rtreichl/weather_station/eagle/uv-light/Light-UV-Sensor-Board.png

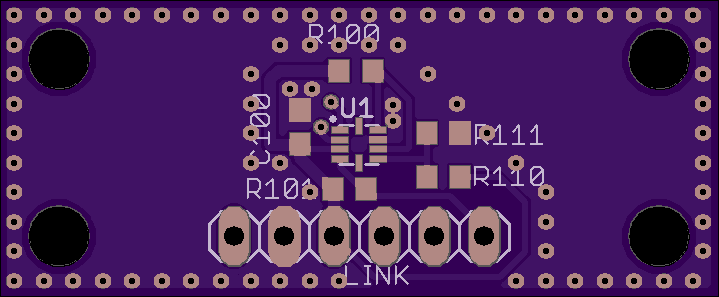
eagle/uv-light/Light-UV-Sensor-Board.png
