rtreichl/weather_station/eagle/uv-light/uv-light-sensor.brd

## EAGLE design eagle/uv-light/uv-light-sensor.brd (2016-05-16)

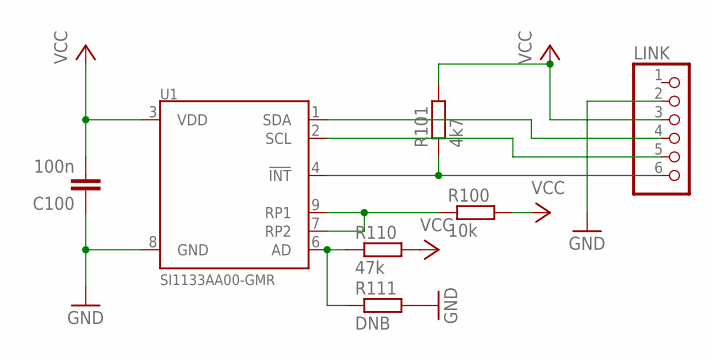
[picture p4: schematic uv-light-sensor.sch]

Parts:
C100: 100n; C0603
LINK: PINHD-1X6; 1X06
R100: 10k; R0603
R101: 4k7; R0603
R110: 47k; R0603
R111: DNB; R0603
U1: SI1133AA00-GMR; QFN-10/2MM

Connections:
GND: C100.1, LINK.2, R111.2, U1.8 (GND)
unnamed: LINK.6, R101.1, U1.4 (!INT)
unnamed: LINK.5, U1.2 (SCL)
unnamed: LINK.4, U1.1 (SDA)
unnamed: R100.1, U1.7 (RP2), U1.9 (RP1)
unnamed: R110.1, R111.1, U1.6 (AD)
VCC: C100.2, LINK.3, R100.2, R101.2, R110.2, U1.3 (VDD)

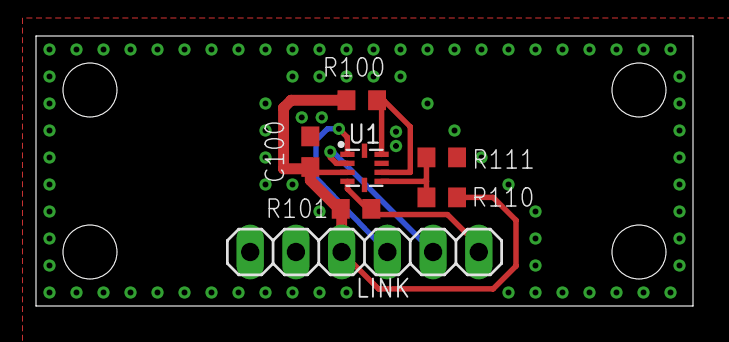
[picture p5: board eagle/uv-light/uv-light-sensor.brd from above]

Board: 2 copper layers, 36.5 x 15.0 mm, 7 parts (0 on the bottom side), 7 nets.
