rtreichl/weather_station/eagle/outdoorsensor/outdoor-sensor.brd

## EAGLE design eagle/outdoorsensor/outdoor-sensor.brd (2016-05-07)

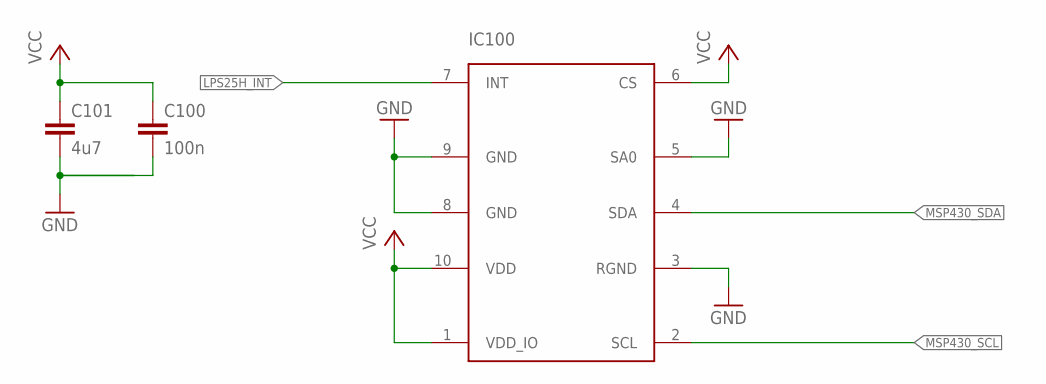
[picture p6: schematic outdoor-sensor.sch, sheet 1, Pressure Sensor LPS25H<br> <a href="http://www.st.com/st-we…]

Parts:
C100: 100n; C0603; MPN STP100NF04
C101: 4u7; C0603
IC100: LPS25H; MPN LPS25HBTR

Connections:
GND: C100.2, C101.2, IC100.3 (RGND), IC100.5 (SA0), IC100.8 (GND), IC100.9 (GND); also elsewhere on the board
LPS25H_INT: IC100.7 (INT); also elsewhere on the board
MSP430_SCL: IC100.2 (SCL); also elsewhere on the board
MSP430_SDA: IC100.4 (SDA); also elsewhere on the board
VCC: C100.1, C101.1, IC100.1 (VDD_IO), IC100.6 (CS), IC100.10 (VDD); also elsewhere on the board

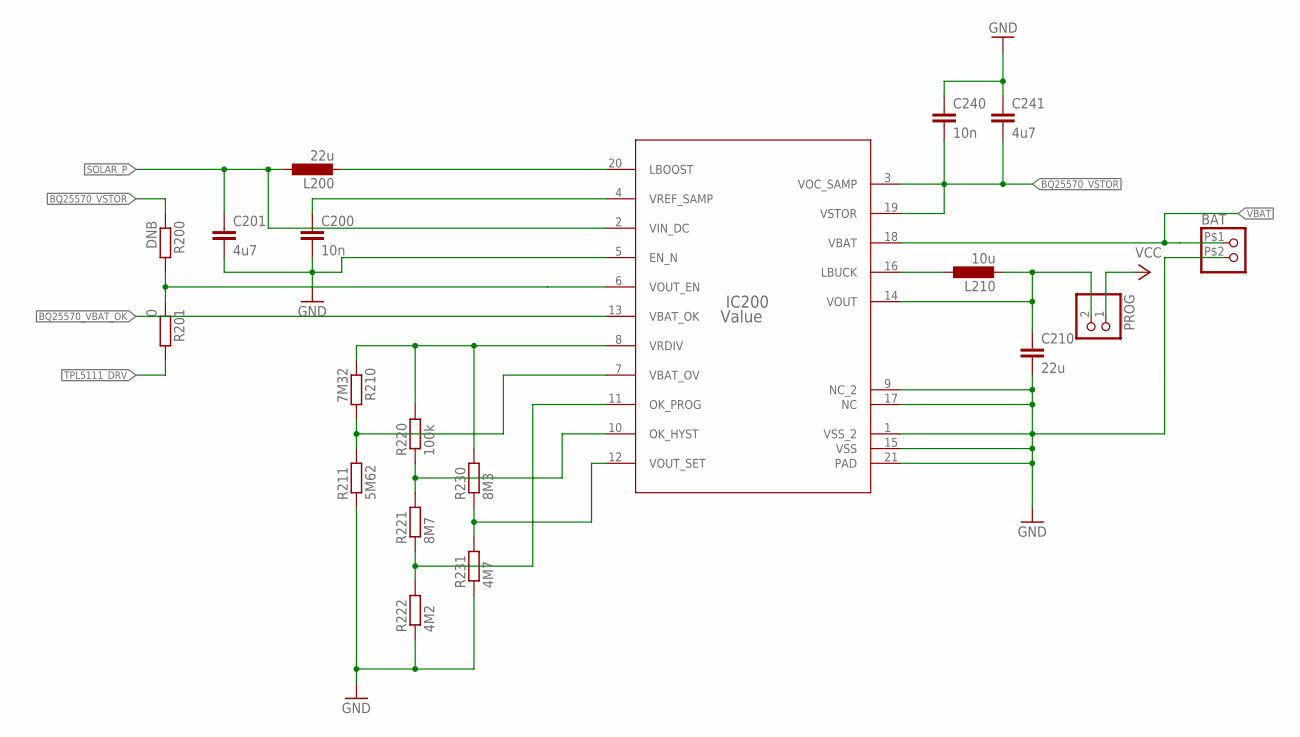
[picture p7: schematic outdoor-sensor.sch, sheet 2, Charger and Buck BQ25570<br> <a href="http://www.ti.com/lit…]

Parts:
!PROG: PINHD-1X2; 1X02
BAT: PINHD-1X2IPBS-102-01-T-S-GP; IPBS-102-01-T-S-GP
C200, C240: 10n; C0603
C201, C241: 4u7; C0603
C210: 22u; C0603; MPN 06034D226MAT2A
IC200: Value; RGR0020A
L200: 22u; L3944
L210: 10u; L2.5X2.0
R200: DNB; R0603
R201: 0; R0603
R210: 7M32; R0603
R211: 5M62; R0603
R220: 100k; R0603
R221: 8M7; R0603
R222: 4M2; R0603
R230: 8M3; R0603
R231: 4M7; R0603

Connections:
BQ25570_VBAT_OK: IC200.13 (VBAT_OK); also elsewhere on the board
BQ25570_VOUT_EN: IC200.6 (VOUT_EN), R200.2, R201.1
BQ25570_VSTOR: C240.2, C241.2, IC200.3 (VOC_SAMP), IC200.19 (VSTOR), R200.1; also elsewhere on the board
GND: BAT.P$2 (2), C200.2, C201.2, C210.2, C240.1, C241.1, IC200.1 (VSS_2), IC200.5 (EN_N), IC200.9 (NC_2), IC200.15 (VSS), IC200.17 (NC), IC200.21 (PAD), R211.1, R222.1, R231.1; also elsewhere on the board
unnamed: IC200.10 (OK_HYST), R220.1, R221.2
unnamed: IC200.8 (VRDIV), R210.1, R220.2, R230.2
unnamed: IC200.7 (VBAT_OV), R210.2, R211.2
unnamed: IC200.11 (OK_PROG), R221.1, R222.2
unnamed: IC200.20 (LBOOST), L200.P$2 (2)
unnamed: C200.1, IC200.4 (VREF_SAMP)
unnamed: IC200.12 (VOUT_SET), R230.1, R231.2
unnamed: !PROG.2, C210.1, IC200.14 (VOUT), L210.P$2 (2)
unnamed: IC200.16 (LBUCK), L210.P$1 (1)
SOLAR_P: C201.1, IC200.2 (VIN_DC), L200.P$1 (1); also elsewhere on the board
TPL5111_DRV: R201.2; also elsewhere on the board
VBAT: BAT.P$1 (1), IC200.18 (VBAT); also elsewhere on the board
VCC: !PROG.1; also elsewhere on the board

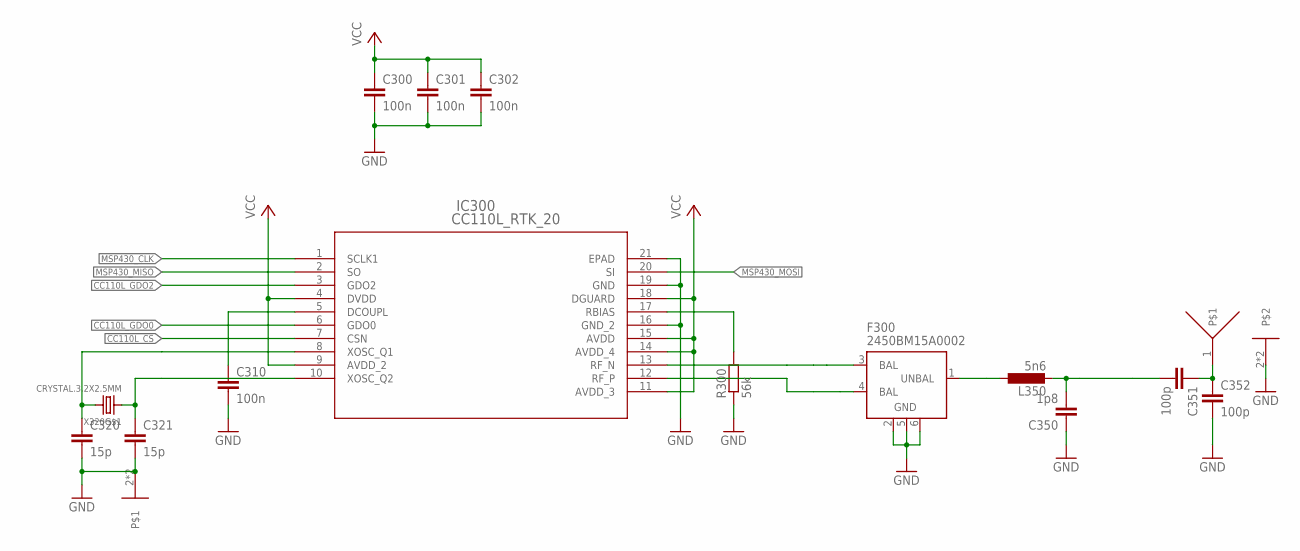
[picture p8: schematic outdoor-sensor.sch, sheet 3, Sub 1-GHz Transceiver CC110L<br> <a href="http://www.ti.com…]

Parts:
C300, C301, C302, C310: 100n; C0603; MPN STP100NF04
C320, C321: 15p; C0603
C350: 1p8; C0603K
C351: 100p; C0603
C352: 100p; C0603K
F300: 2450BM15A0002
IC300: CC110L_RTK_20; RTK20_2P4X2P4
L350: 5n6; L2012C
R300: 56k; R0603
U$1: ANTENNA868W3013-INV; W3013-INV
X320: CRYSTAL.3.2X2.5MM; 3.2X2.5MM

Connections:
!CC110L_CS: IC300.7 (CSN); also elsewhere on the board
CC110L_GDO0: IC300.6 (GDO0); also elsewhere on the board
CC110L_GDO2: IC300.3 (GDO2); also elsewhere on the board
GND: C300.2, C301.2, C302.2, C310.2, C320.2, C321.2, C350.1, C352.2, F300.2 (GND), F300.5 (GND), F300.6 (GND), IC300.16 (GND_2), IC300.19 (GND), IC300.21 (EPAD), R300.1, U$1.2, U$1.3, X320.2, X320.4; also elsewhere on the board
MSP430_CLK: IC300.1 (SCLK1); also elsewhere on the board
MSP430_MISO: IC300.2 (SO); also elsewhere on the board
MSP430_MOSI: IC300.20 (SI); also elsewhere on the board
unnamed: C351.1, C352.1, U$1.1
unnamed: F300.1 (UNBAL), L350.1
unnamed: C320.1, IC300.8 (XOSC_Q1), X320.3 (2)
unnamed: F300.3 (BAL), IC300.13 (RF_N)
unnamed: F300.4 (BAL), IC300.12 (RF_P)
unnamed: C350.2, C351.2, L350.2
unnamed: C310.1, IC300.5 (DCOUPL)
unnamed: IC300.17 (RBIAS), R300.2
unnamed: C321.1, IC300.10 (XOSC_Q2), X320.1
VCC: C300.1, C301.1, C302.1, IC300.4 (DVDD), IC300.9 (AVDD_2), IC300.11 (AVDD_3), IC300.14 (AVDD_4), IC300.15 (AVDD), IC300.18 (DGUARD); also elsewhere on the board

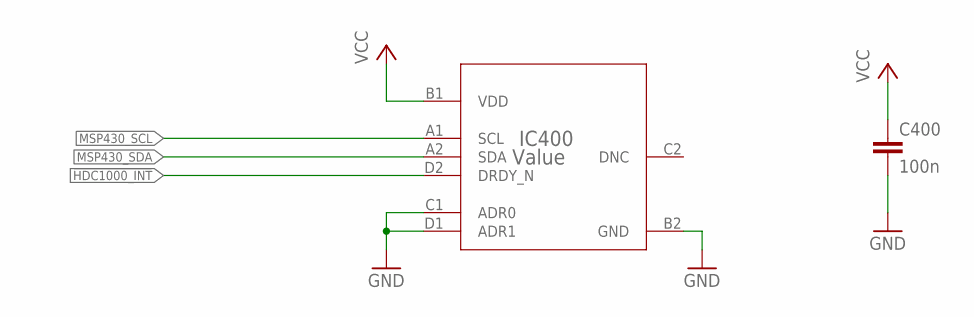
[picture p9: schematic outdoor-sensor.sch, sheet 4, Humidity/Temperature Sensor HDC1000<br> <a href="http://www…]

Parts:
C400: 100n; C0603; MPN STP100NF04
IC400: Value; YPA0008AGAE

Connections:
!HDC1000_INT: IC400.D2 (DRDY_N); also elsewhere on the board
GND: C400.2, IC400.B2 (GND), IC400.C1 (ADR0), IC400.D1 (ADR1); also elsewhere on the board
MSP430_SCL: IC400.A1 (SCL); also elsewhere on the board
MSP430_SDA: IC400.A2 (SDA); also elsewhere on the board
VCC: C400.1, IC400.B1 (VDD); also elsewhere on the board

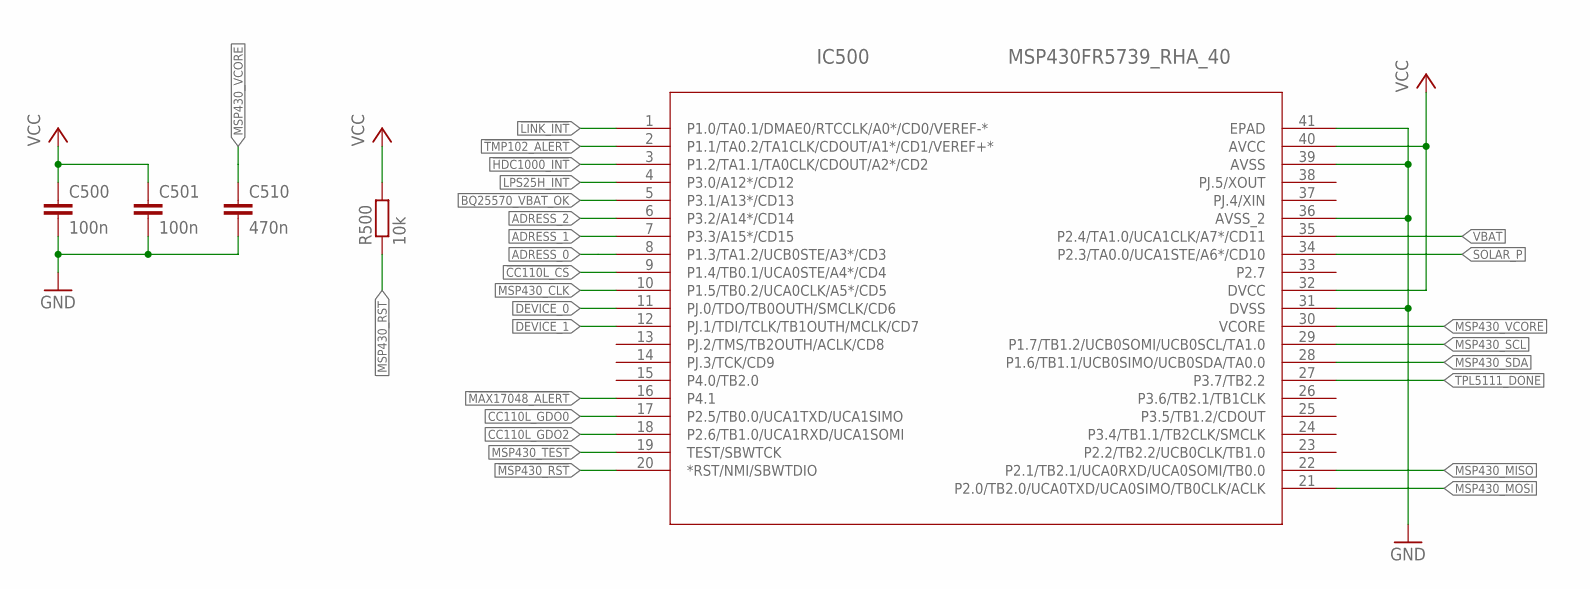
[picture p10: schematic outdoor-sensor.sch, sheet 5, Mikrocontroller]

Parts:
C500, C501: 100n; C0603; MPN STP100NF04
C510: 470n; C0603
IC500: MSP430FR5739_RHA_40; RHA40_2P9X2P9
R500: 10k; R0603

Connections:
!CC110L_CS: IC500.9 (P1.4/TB0.1/UCA0STE/A4*/CD4); also elsewhere on the board
!HDC1000_INT: IC500.3 (P1.2/TA1.1/TA0CLK/CDOUT/A2*/CD2); also elsewhere on the board
!LINK_INT: IC500.1 (P1.0/TA0.1/DMAE0/RTCCLK/A0*/CD0/VEREF-*); also elsewhere on the board
!MAX17048_ALERT: IC500.16 (P4.1); also elsewhere on the board
!MSP430_RST: IC500.20 (*RST/NMI/SBWTDIO), R500.1; also elsewhere on the board
!TMP102_ALERT: IC500.2 (P1.1/TA0.2/TA1CLK/CDOUT/A1*/CD1/VEREF+*); also elsewhere on the board
ADRESS_0: IC500.8 (P1.3/TA1.2/UCB0STE/A3*/CD3); also elsewhere on the board
ADRESS_1: IC500.7 (P3.3/A15*/CD15); also elsewhere on the board
ADRESS_2: IC500.6 (P3.2/A14*/CD14); also elsewhere on the board
BQ25570_VBAT_OK: IC500.5 (P3.1/A13*/CD13); also elsewhere on the board
CC110L_GDO0: IC500.17 (P2.5/TB0.0/UCA1TXD/UCA1SIMO); also elsewhere on the board
CC110L_GDO2: IC500.18 (P2.6/TB1.0/UCA1RXD/UCA1SOMI); also elsewhere on the board
DEVICE_0: IC500.11 (PJ.0/TDO/TB0OUTH/SMCLK/CD6); also elsewhere on the board
DEVICE_1: IC500.12 (PJ.1/TDI/TCLK/TB1OUTH/MCLK/CD7); also elsewhere on the board
GND: C500.2, C501.2, C510.2, IC500.31 (DVSS), IC500.36 (AVSS_2), IC500.39 (AVSS), IC500.41 (EPAD); also elsewhere on the board
LPS25H_INT: IC500.4 (P3.0/A12*/CD12); also elsewhere on the board
MSP430_CLK: IC500.10 (P1.5/TB0.2/UCA0CLK/A5*/CD5); also elsewhere on the board
MSP430_MISO: IC500.22 (P2.1/TB2.1/UCA0RXD/UCA0SOMI/TB0.0); also elsewhere on the board
MSP430_MOSI: IC500.21 (P2.0/TB2.0/UCA0TXD/UCA0SIMO/TB0CLK/ACLK); also elsewhere on the board
MSP430_SCL: IC500.29 (P1.7/TB1.2/UCB0SOMI/UCB0SCL/TA1.0); also elsewhere on the board
MSP430_SDA: IC500.28 (P1.6/TB1.1/UCB0SIMO/UCB0SDA/TA0.0); also elsewhere on the board
MSP430_TEST: IC500.19 (TEST/SBWTCK); also elsewhere on the board
MSP430_VCORE: C510.1, IC500.30 (VCORE)
SOLAR_P: IC500.34 (P2.3/TA0.0/UCA1STE/A6*/CD10); also elsewhere on the board
TPL5111_DONE: IC500.27 (P3.7/TB2.2); also elsewhere on the board
VBAT: IC500.35 (P2.4/TA1.0/UCA1CLK/A7*/CD11); also elsewhere on the board
VCC: C500.1, C501.1, IC500.32 (DVCC), IC500.40 (AVCC), R500.2; also elsewhere on the board

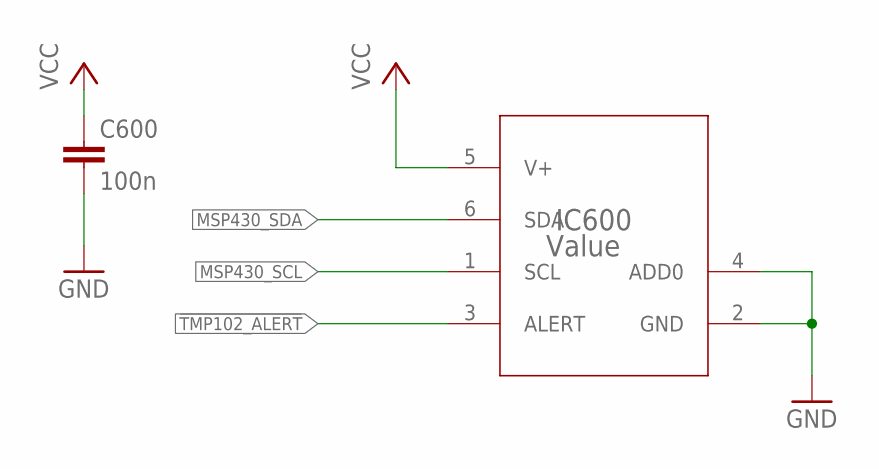
[picture p11: schematic outdoor-sensor.sch, sheet 6, Temperature Sensor TMP102-Q1<br> <a href="http://www.ti.com…]

Parts:
C600: 100n; C0603; MPN STP100NF04
IC600: Value; DRL0006A

Connections:
!TMP102_ALERT: IC600.3 (ALERT); also elsewhere on the board
GND: C600.2, IC600.2 (GND), IC600.4 (ADD0); also elsewhere on the board
MSP430_SCL: IC600.1 (SCL); also elsewhere on the board
MSP430_SDA: IC600.6 (SDA); also elsewhere on the board
VCC: C600.1, IC600.5 (V+); also elsewhere on the board

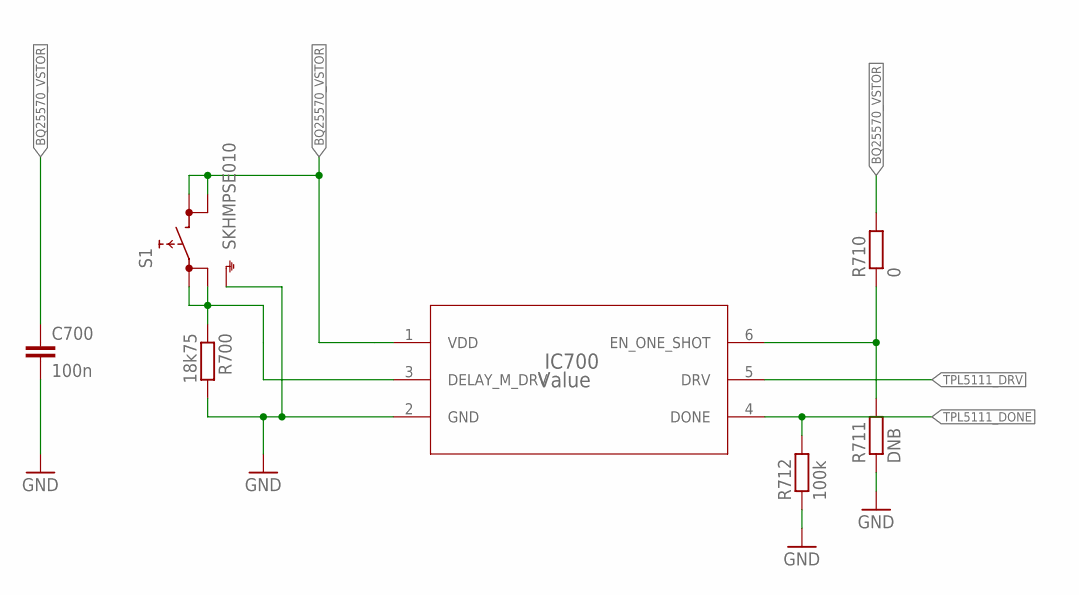
[picture p12: schematic outdoor-sensor.sch, sheet 7, Nano low power timer TPL5010<br> <a href="http://www.ti.com…]

Parts:
C700: 100n; C0603; MPN STP100NF04
IC700: Value; DDC0006A_N
R700: 18k75; R0603
R710: 0; R0603
R711: DNB; R0603
R712: 100k; R0603
S1: SKHMPSE010; SKHMPXE010

Connections:
BQ25570_VSTOR: C700.1, IC700.1 (VDD), R710.2, S1.3 (2.1), S1.4 (2.2); also elsewhere on the board
GND: C700.2, IC700.2 (GND), R700.2, R711.1, R712.1, S1.5 (SH); also elsewhere on the board
unnamed: IC700.3 (DELAY_M_DRV), R700.1, S1.1 (1.1), S1.2 (1.2)
TPL5010_RST_N: IC700.6 (EN_ONE_SHOT), R710.1, R711.2
TPL5111_DONE: IC700.4 (DONE), R712.2; also elsewhere on the board
TPL5111_DRV: IC700.5 (DRV); also elsewhere on the board

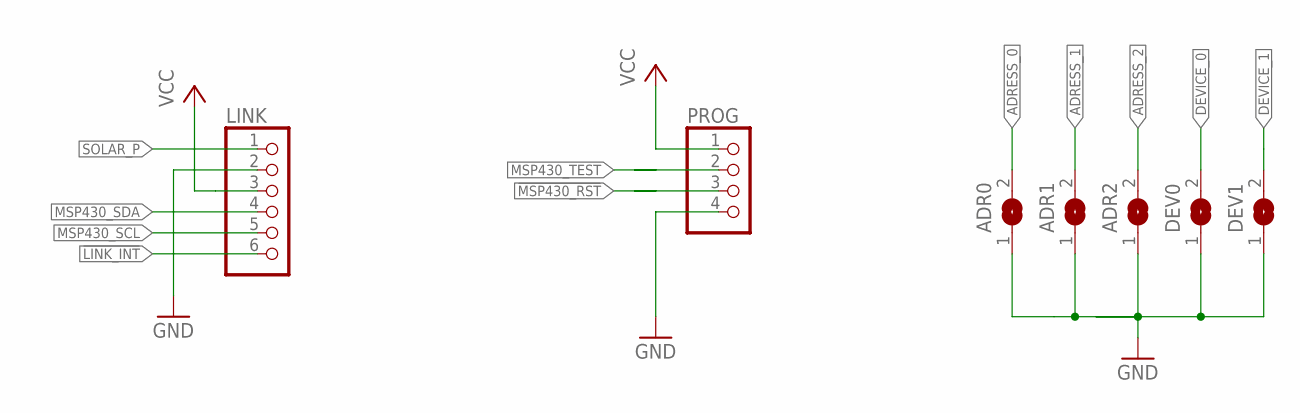
[picture p13: schematic outdoor-sensor.sch, sheet 8, Connectors]

Parts:
ADR0, ADR1, ADR2: SJW
DEV0, DEV1: SJW
LINK: PINHD-1X6; 1X06
PROG: PINHD-1X4; 1X04

Connections:
!LINK_INT: LINK.6; also elsewhere on the board
!MSP430_RST: PROG.3; also elsewhere on the board
ADRESS_0: ADR0.2; also elsewhere on the board
ADRESS_1: ADR1.2; also elsewhere on the board
ADRESS_2: ADR2.2; also elsewhere on the board
DEVICE_0: DEV0.2; also elsewhere on the board
DEVICE_1: DEV1.2; also elsewhere on the board
GND: ADR0.1, ADR1.1, ADR2.1, DEV0.1, DEV1.1, LINK.2, PROG.4; also elsewhere on the board
MSP430_SCL: LINK.5; also elsewhere on the board
MSP430_SDA: LINK.4; also elsewhere on the board
MSP430_TEST: PROG.2; also elsewhere on the board
SOLAR_P: LINK.1; also elsewhere on the board
VCC: LINK.3, PROG.1; also elsewhere on the board

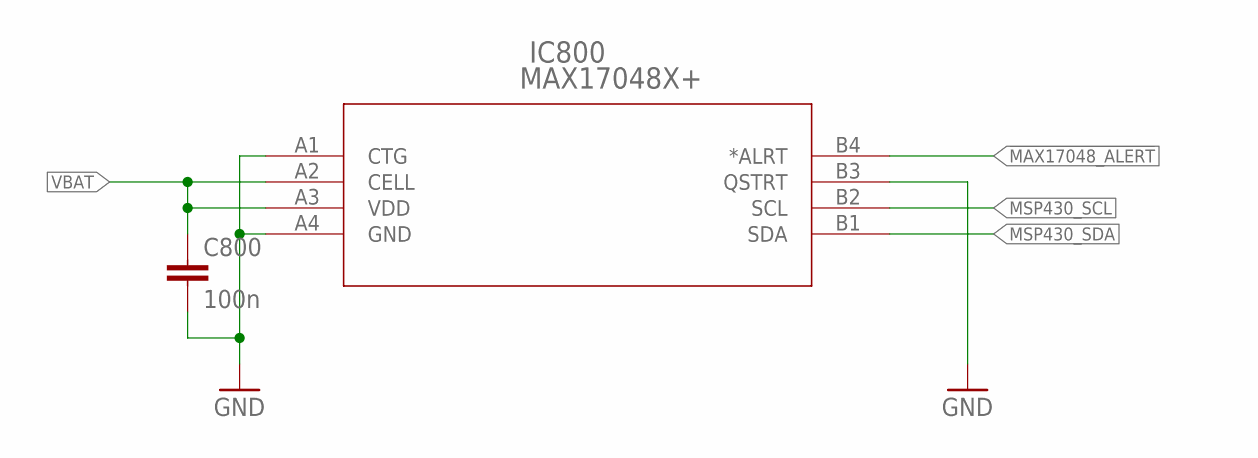
[picture p14: schematic outdoor-sensor.sch, sheet 9]

Parts:
C800: 100n; C0603
IC800: MAX17048X+; 21-0555B_W80B1-1

Connections:
!MAX17048_ALERT: IC800.B4 (*ALRT); also elsewhere on the board
GND: C800.2, IC800.A1 (CTG), IC800.A4 (GND), IC800.B3 (QSTRT); also elsewhere on the board
MSP430_SCL: IC800.B2 (SCL); also elsewhere on the board
MSP430_SDA: IC800.B1 (SDA); also elsewhere on the board
VBAT: C800.1, IC800.A2 (CELL), IC800.A3 (VDD); also elsewhere on the board

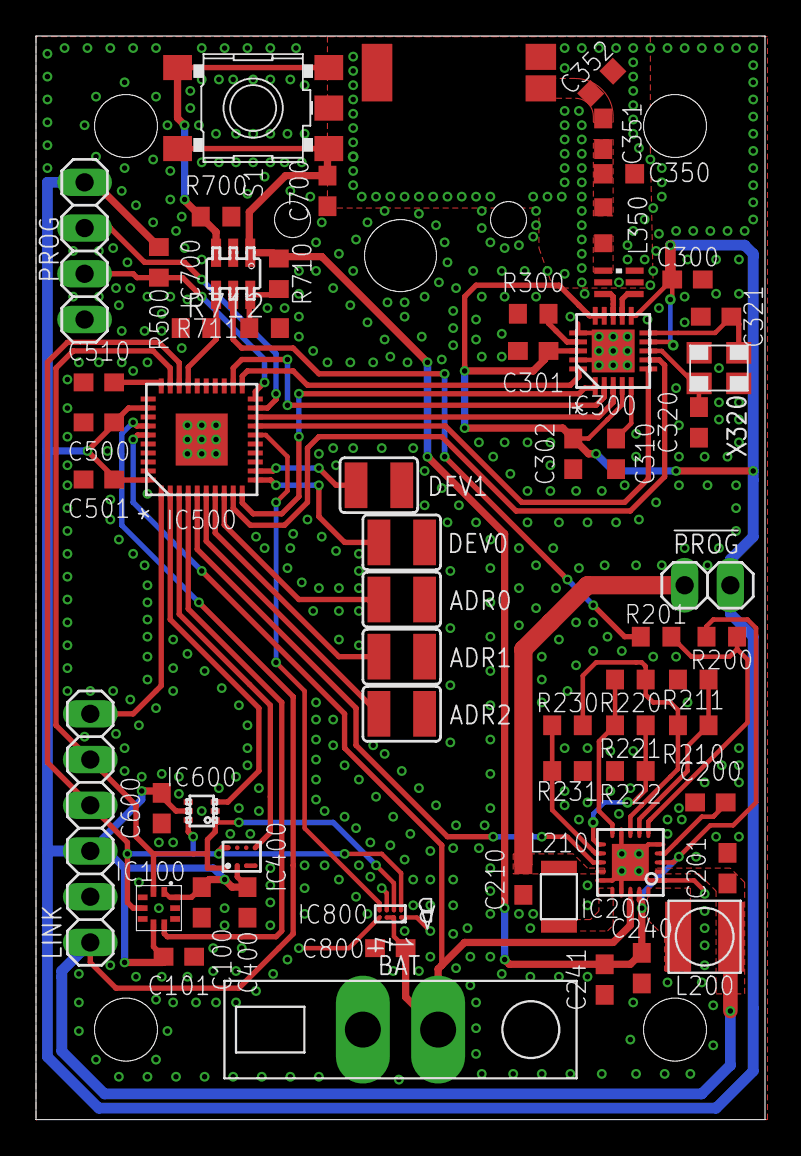
[picture p15: board outdoor-sensor.brd from above]

Board: 2 copper layers, 40.5 x 60.2 mm, 62 parts (0 on the bottom side), 50 nets.
