rtreichl/weather_station/eagle/rapi-receiver/receiver.brd

## EAGLE design eagle/rapi-receiver/receiver.brd (2015-10-21)

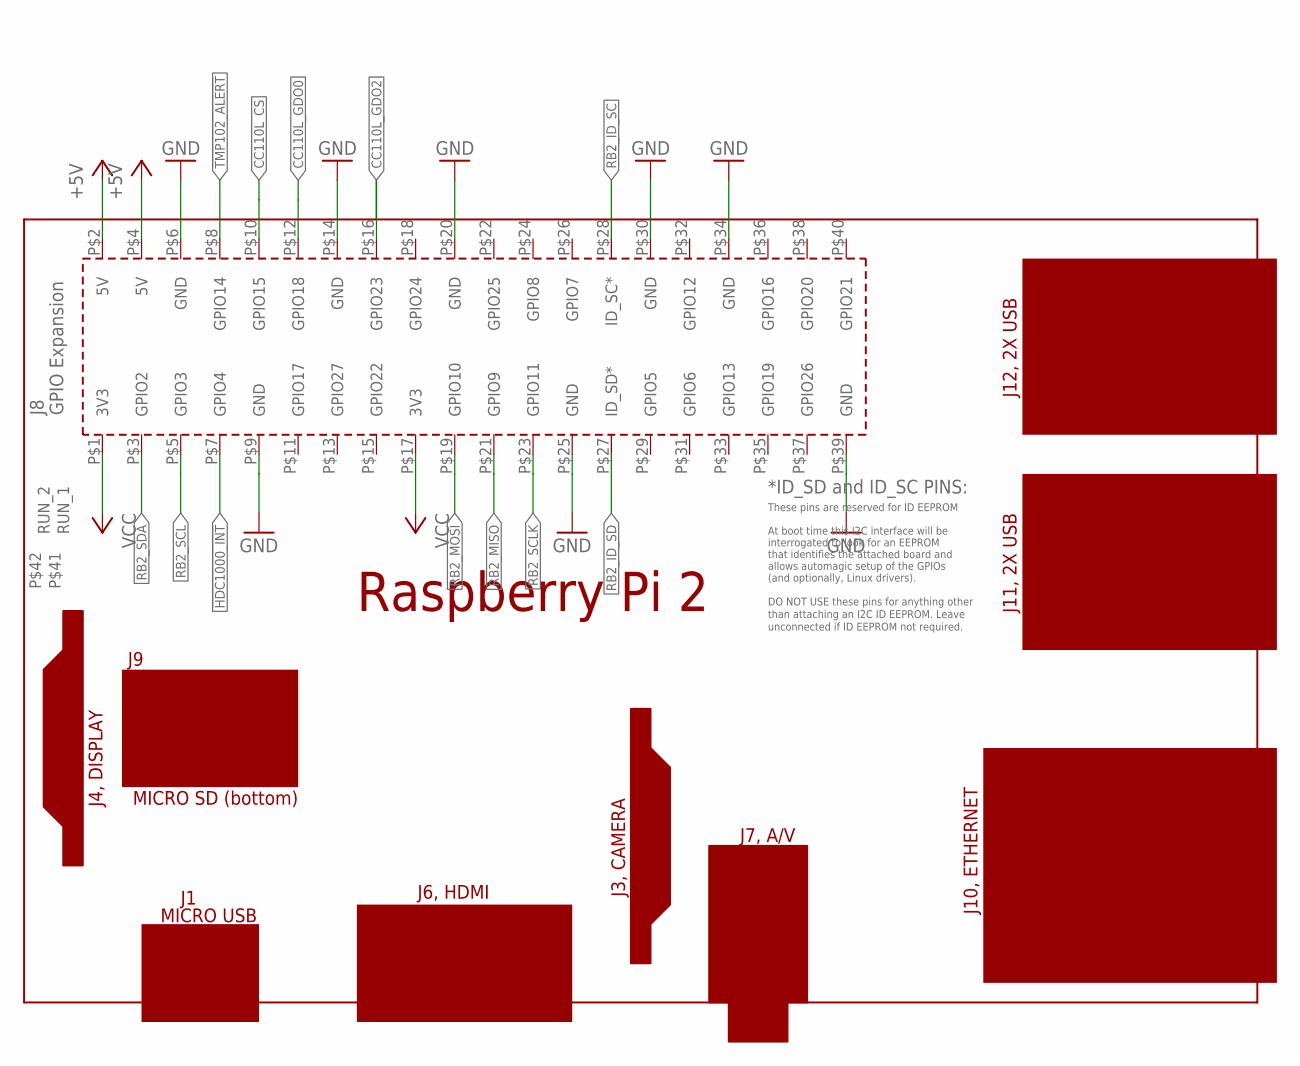
[picture p16: schematic receiver.sch, sheet 1, Raspberry PI 2 Extention Board<br> <a href="http://elinux.o…]

Parts:
PCB1: RPI2

Connections:
!HDC1000_INT: PCB1.P$7 (GPIO4); also elsewhere on the board
!TMP102_ALERT: PCB1.P$8 (GPIO14); also elsewhere on the board
+5V: PCB1.P$2 (5V), PCB1.P$4 (5V)
CC110L_CS: PCB1.P$10 (GPIO15); also elsewhere on the board
CC110L_GDO0: PCB1.P$12 (GPIO18); also elsewhere on the board
CC110L_GDO2: PCB1.P$16 (GPIO23); also elsewhere on the board
GND: PCB1.P$6 (GND), PCB1.P$9 (GND), PCB1.P$14 (GND), PCB1.P$20 (GND), PCB1.P$25 (GND), PCB1.P$30 (GND), PCB1.P$34 (GND), PCB1.P$39 (GND); also elsewhere on the board
RB2_ID_SC: PCB1.P$28 (ID_SC*); also elsewhere on the board
RB2_ID_SD: PCB1.P$27 (ID_SD*); also elsewhere on the board
RB2_MISO: PCB1.P$21 (GPIO9); also elsewhere on the board
RB2_MOSI: PCB1.P$19 (GPIO10); also elsewhere on the board
RB2_SCL: PCB1.P$5 (GPIO3); also elsewhere on the board
RB2_SCLK: PCB1.P$23 (GPIO11); also elsewhere on the board
RB2_SDA: PCB1.P$3 (GPIO2); also elsewhere on the board
VCC: PCB1.P$1 (3V3), PCB1.P$17 (3V3); also elsewhere on the board

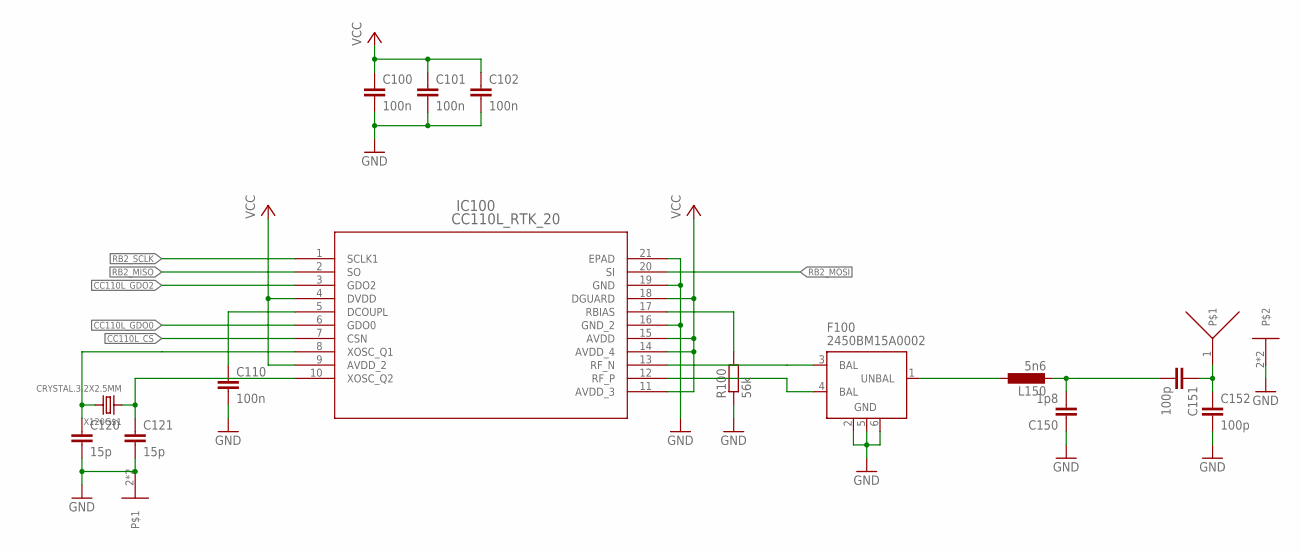
[picture p17: schematic receiver.sch, sheet 2, Transceiver CC110L<br> <a href="http://www.ti.com/lit/ds/sy…]

Parts:
C100, C101, C102, C110: 100n; C0603
C120, C121: 15p; C0603
C150: 1p8; C0603K
C151: 100p; C0603
C152: 100p; C0603K
F100: 2450BM15A0002
IC100: CC110L_RTK_20; RTK20_2P4X2P4
L150: 5n6; L2012C
R100: 56k; R0603
U$1: ANTENNA868W3013-INV; W3013-INV
X120: CRYSTAL.3.2X2.5MM; 3.2X2.5MM

Connections:
CC110L_CS: IC100.7 (CSN); also elsewhere on the board
CC110L_GDO0: IC100.6 (GDO0); also elsewhere on the board
CC110L_GDO2: IC100.3 (GDO2); also elsewhere on the board
GND: C100.2, C101.2, C102.2, C110.2, C120.2, C121.2, C150.1, C152.2, F100.2 (GND), F100.5 (GND), F100.6 (GND), IC100.16 (GND_2), IC100.19 (GND), IC100.21 (EPAD), R100.1, U$1.2, U$1.3, X120.2, X120.4; also elsewhere on the board
unnamed: C151.1, C152.1, U$1.1
unnamed: C120.1, IC100.8 (XOSC_Q1), X120.3 (2)
unnamed: F100.1 (UNBAL), L150.1
unnamed: F100.3 (BAL), IC100.13 (RF_N)
unnamed: F100.4 (BAL), IC100.12 (RF_P)
unnamed: C150.2, C151.2, L150.2
unnamed: C110.1, IC100.5 (DCOUPL)
unnamed: IC100.17 (RBIAS), R100.2
unnamed: C121.1, IC100.10 (XOSC_Q2), X120.1
RB2_MISO: IC100.2 (SO); also elsewhere on the board
RB2_MOSI: IC100.20 (SI); also elsewhere on the board
RB2_SCLK: IC100.1 (SCLK1); also elsewhere on the board
VCC: C100.1, C101.1, C102.1, IC100.4 (DVDD), IC100.9 (AVDD_2), IC100.11 (AVDD_3), IC100.14 (AVDD_4), IC100.15 (AVDD), IC100.18 (DGUARD); also elsewhere on the board

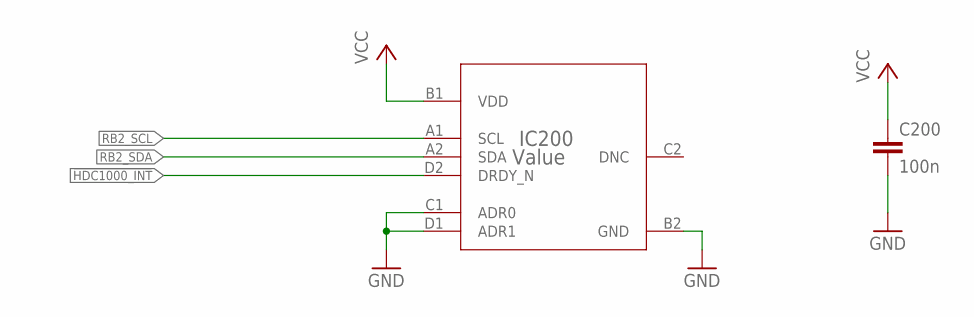
[picture p18: schematic receiver.sch, sheet 3, Humidity and Temperature Sensor HDC1000<br> <a href="http:/…]

Parts:
C200: 100n; C0603
IC200: Value; YPA0008AGAE

Connections:
!HDC1000_INT: IC200.D2 (DRDY_N); also elsewhere on the board
GND: C200.2, IC200.B2 (GND), IC200.C1 (ADR0), IC200.D1 (ADR1); also elsewhere on the board
RB2_SCL: IC200.A1 (SCL); also elsewhere on the board
RB2_SDA: IC200.A2 (SDA); also elsewhere on the board
VCC: C200.1, IC200.B1 (VDD); also elsewhere on the board

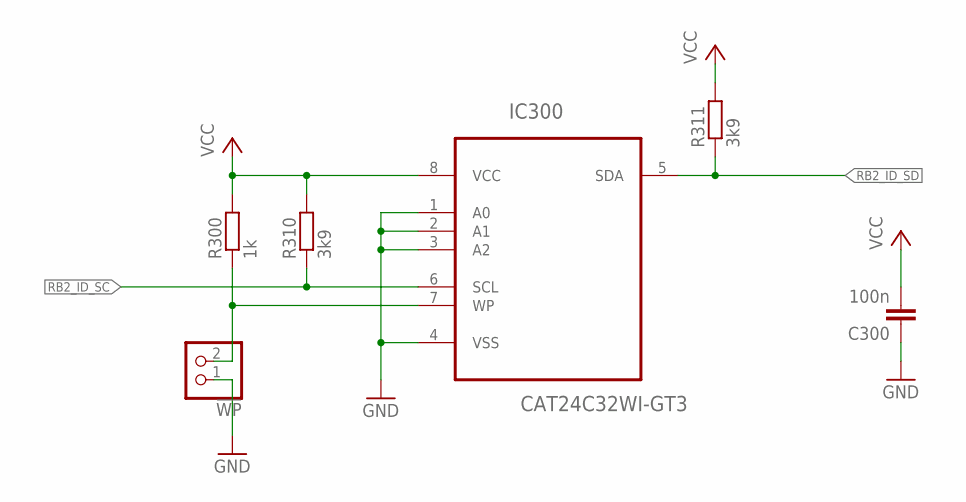
[picture p19: schematic receiver.sch, sheet 4, EEPROM CAT24C32WI<br> <a href="http://www.onsemi.com/pub_li…]

Parts:
!WP: PINHD-1X2; 1X02
C300: 100n; C0603
IC300: CAT24C32WI-GT3; SOIC127P600X175-8N
R300: 1k; R0603
R310, R311: 3k9; R0603

Connections:
GND: !WP.1, C300.1, IC300.1 (A0), IC300.2 (A1), IC300.3 (A2), IC300.4 (VSS); also elsewhere on the board
unnamed: !WP.2, IC300.7 (WP), R300.1
RB2_ID_SC: IC300.6 (SCL), R310.1; also elsewhere on the board
RB2_ID_SD: IC300.5 (SDA), R311.1; also elsewhere on the board
VCC: C300.2, IC300.8 (VCC), R300.2, R310.2, R311.2; also elsewhere on the board

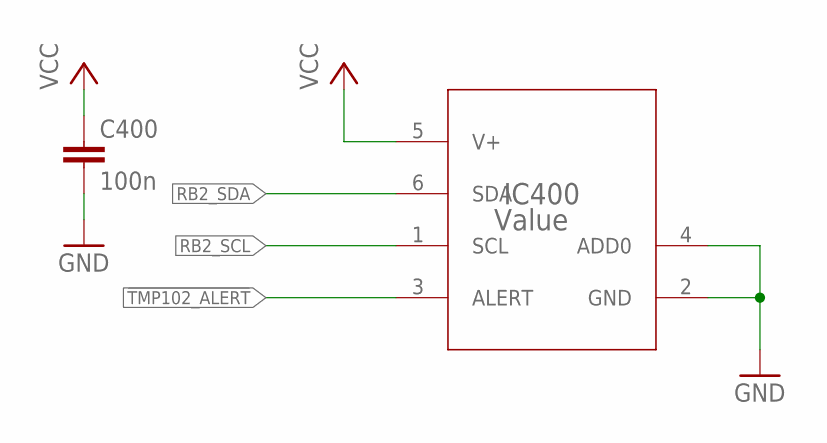
[picture p20: schematic receiver.sch, sheet 5, Temperature Sensor<br> <a href="http://www.ti.com/lit/ds/sy…]

Parts:
C400: 100n; C0603
IC400: Value; DRL0006A

Connections:
!TMP102_ALERT: IC400.3 (ALERT); also elsewhere on the board
GND: C400.2, IC400.2 (GND), IC400.4 (ADD0); also elsewhere on the board
RB2_SCL: IC400.1 (SCL); also elsewhere on the board
RB2_SDA: IC400.6 (SDA); also elsewhere on the board
VCC: C400.1, IC400.5 (V+); also elsewhere on the board

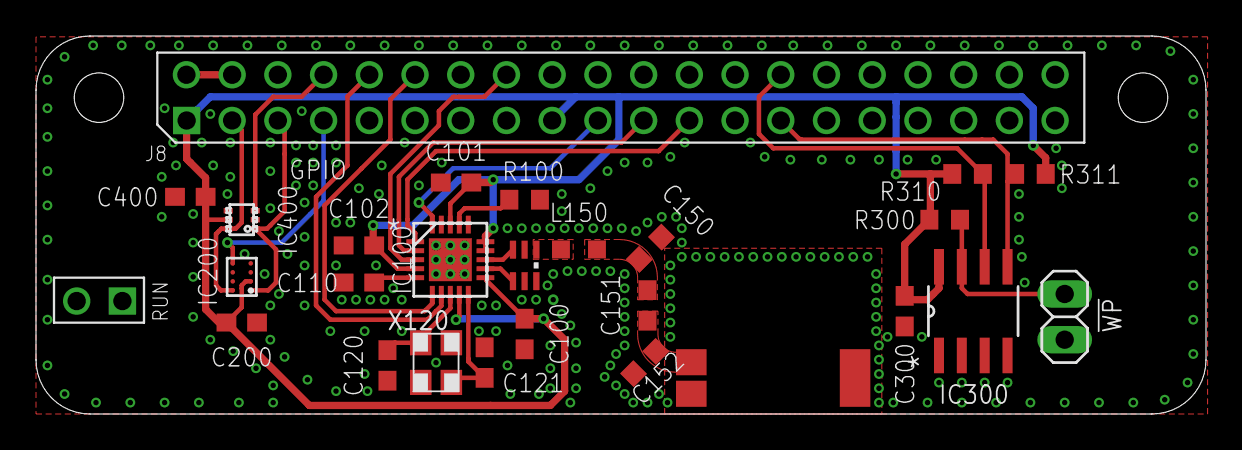
[picture p21: board receiver.brd from above]

Board: 2 copper layers, 65.0 x 21.0 mm, 26 parts (0 on the bottom side), 25 nets.
