rtreichl/weather_station/eagle/light/uv-light-sensor.brd

## EAGLE design eagle/light/uv-light-sensor.brd (2015-08-13)

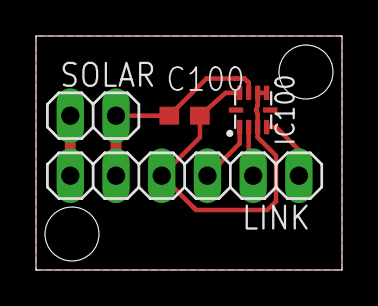
[picture p22: board eagle/light/uv-light-sensor.brd from above]

Board: 2 copper layers, 17.0 x 13.0 mm, 4 parts (0 on the bottom side), 6 nets.

Parts:
C100: 100n; C0603
IC100: SI1147; QFN-10/2MM
LINK: 1X06
SOLAR: 1X02

Connections:
GND: C100.1, IC100.8, LINK.2, SOLAR.1
unnamed: IC100.4, LINK.6
unnamed: IC100.2, LINK.5
unnamed: IC100.1, LINK.4
unnamed: LINK.1, SOLAR.2
VCC: C100.2, IC100.3, IC100.6, IC100.7, IC100.9, LINK.3
