rtreichl/weather_station/msp430/OutdoorSensor/driver/intern/gpio/src/gpio.c

///----------------------------------------------------------------------------------------
///
/// \file gpio.c
///
/// \brief 
///
/// \date 17.02.2016
///
/// \author Richard Treichl
///
/// \remark
///
/// \todo
///
/// \version	1.0
///
///----------------------------------------------------------------------------------------

#include <driver.h>
#include "../include/gpio.h"

#ifdef __MSP430_HAS_PORT1_R__
#if GPIO_PORT1_INTERRUPT == GPIO_INTERRUPT_ON
	extern gpio_ptrfunc gpio1_isrs[];
#endif
#endif
#ifdef __MSP430_HAS_PORT2_R__
#if GPIO_PORT2_INTERRUPT == GPIO_INTERRUPT_ON
	extern gpio_ptrfunc gpio2_isrs[];
#endif
#endif
#ifdef __MSP430_HAS_PORT3_R__
#if GPIO_PORT3_INTERRUPT == GPIO_INTERRUPT_ON
	extern gpio_ptrfunc gpio3_isrs[];
#endif
#endif
#ifdef __MSP430_HAS_PORT4_R__
#if GPIO_PORT4_INTERRUPT == GPIO_INTERRUPT_ON
	extern gpio_ptrfunc gpio4_isrs[];
#endif
#endif
#ifdef __MSP430_HAS_PORT5_R__
#if GPIO_PORT5_INTERRUPT == GPIO_INTERRUPT_ON
	extern gpio_ptrfunc gpio5_isrs[];
#endif
#endif
#ifdef __MSP430_HAS_PORT6_R__
#if GPIO_PORT6_INTERRUPT == GPIO_INTERRUPT_ON
	extern gpio_ptrfunc gpio6_isrs[];
#endif
#endif
#ifdef __MSP430_HAS_PORT7_R__
#if GPIO_PORT7_INTERRUPT == GPIO_INTERRUPT_ON
	extern gpio_ptrfunc gpio7_isrs[];
#endif
#endif
#ifdef __MSP430_HAS_PORT8_R__
#if GPIO_PORT8_INTERRUPT == GPIO_INTERRUPT_ON
	extern gpio_ptrfunc gpio8_isrs[];
#endif
#endif
#ifdef __MSP430_HAS_PORT9_R__
#if GPIO_PORT9_INTERRUPT == GPIO_INTERRUPT_ON
	extern gpio_ptrfunc gpio9_isrs[];
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
		break;
#endif
#endif
	default:
		break;
	}
	return 0;
}

uint16_t GpioEnableInterupt(GPIO8_PORT port, GPIO_PIN pin)
{
	GPIO8_IFG(port) &= ~pin;
	GPIO8_IE(port) |= pin;
	return 0;
}

uint16_t GpioDisableInterupt(GPIO8_PORT port, GPIO_PIN pin)
{
	GPIO8_IE(port) &= ~pin;
	return 0;
}
