rtreichl/weather_station/msp430/OutdoorSensor/app/src/communication.c

///----------------------------------------------------------------------------------------
///
/// \file communication.c
///
/// \brief 
///
/// \date 26.02.2016
///
/// \author Richard Treichl
///
/// \remark
///
/// \todo
///
/// \version	1.0
///
///----------------------------------------------------------------------------------------

//uint16_t communication_init()
//{
//	return 0;
//}
//
//uint16_t communication_registration()
//{
//	//Header -> Protocol for registaiton
//	//Wait for -> Response and next time Slot
//	return 0;
//}
//
//uint16_t communication_send_information()
//{
//	//Header -> Protocol for information msb(2) for information lsb(6)
//	PROTOCOL_STC Protocol;
//	Protocol.dest_addr = 0;
//
//	//Wait for -> Response and offset time
//	return 0;
//}
//
//uint16_t communication_send_data()
//{
//	//Header -> Protocol for data msb(2) for data lsb(6)
//	//Go offline
//	return 0;
//}
