rtreichl/weather_station/raspi/receiver/src/configfile.h

/*
 * CONFIGFILE.h
 *
 *  Created on: 04.02.2016
 *      Author: Richard Treichl
 */

#ifndef CONFIGFILE_H_
#define CONFIGFILE_H_

class CONFIGFILE {
public:
	CONFIGFILE();
	virtual ~CONFIGFILE();
};

#endif /* CONFIGFILE_H_ */
