rtreichl/weather_station/(commit log)

2015-08-13 ADD: Schematics and layout for outdoor light sensor and receiver for raspberry pi 2
    [outdoor-sensor.brd, outdoor-sensor.sch, receiver.brd, receiver.sch, uv-light-sensor.brd, uv-light-sensor.sch]
2015-10-21 CHG: updated lib, schematics and boards
    [outdoor-sensor.brd, outdoor-sensor.sch, receiver.brd, receiver.sch, uv-light-sensor.brd, uv-light-sensor.sch]
2016-01-28 CHG: Updated schematics and layout
    [outdoor-sensor.brd, outdoor-sensor.sch]
2016-02-17 CHG: Removed extern_interrupt_handler and replaced with with new gpio interface
    [gpio.c, gpio.h, gpio_port1.c, gpio_port10.c, gpio_port11.c, gpio_port2.c, gpio_port3.c, gpio_port4.c]
2016-02-17 CHG: Added new timer interface
2016-02-17 CHG: reworked database data handling and added rssi for database insert
    [database.cpp, database.h]
2016-02-17 FIX: fixed some bugs on cc110l driver
    [cc110l.cpp, cc110l.h, cc110l_config2.h]
2016-02-26 FIX: Moved config from ram to rom
    [cc110l_config2.h]
2016-02-26 ADD: added a onewire driver. Port and Pin are selectable
2016-02-26 CHG: Improved timer driver and fixed some bugs
2016-02-26 ADD: Added an check slave function to i2c for checking availability
2016-02-26 ADD: Added driver for DS18B20 Temp. sensor
2016-02-26 FIX: fixed a bug with GPIO ISR
    [gpio_port1.c]
2016-02-26 ADD: Added files for driver lib. Driver lib will be moved out of this repo. to a independently one
2016-02-29 ADD: added a i2c_slave_check function to prove if the slave exists
2016-02-29 CHG: SPI clock divider is now 2 instead of 4
2016-05-07 CHG: reworked some timings
    [app.c, device.c, protocol.c]
2016-05-07 CHG: reworked Raspi Code
    [Command.cpp, Command.h, CommandParser.cpp, CommandParser.h]
2016-05-07 CHG: fixed some issuses on pcb
    [outdoor-sensor.brd, outdoor-sensor.sch]
2016-05-07 CHG: changed drivers to gcc
2016-05-07 FIX: fixed problems with gcc
    [app.h, communication.c, main.c, protocol.h]
2016-05-16 CHG: Replaced Si1147 through Si1133
    [uv-light-sensor.brd, uv-light-sensor.sch]
2016-06-03 Add PCB Image
